VIP-LES/leos-power-pcb/Sp26 Power Board Calculations and Documentation.docx

The power board has two buck converters on it, one to go from the battery voltage (~22.2V to 12V) and another to go from 12V to 5V. This documentation covers the design decisions and calculations for the 22.2V to 12V buck converter.

This buck converter was designed using this buck converter module: TPS55287 36-V, 4-A Buck-Boost Converter with I2C Interface. The data sheet is linked below.

Data Sheet: https://www.ti.com/lit/ds/symlink/tps55287.pdf?ts=1769081225649

The data sheet provides most of what one will need to design a buck converter, but a few key decisions were made. First, we choose to set the output voltage using an external resistor divider. (See pg. 21 in the data sheet for more details about how this changed the normal application circuit.) We did this because the power board is providing power to the other boards and microcontrollers, so a microcontroller on another board cannot be used to set the output voltage, it has to be set by physical components.

Next, we choose the value for RCDC (or also called R2) to be 20 kΩ because we wanted a higher current draw. (See pg. 22 in the data for a graph of output voltage rise versus output current.)

Calculation:

VIN = 3S (11.1 V) or 6S (22.2 V) to VOUT = 12 V

IOUT_LIM = 3A

IOUT = 1A = IL (in buck converters)

- Default limit voltage (between IISP and IISN) is 50 mV
- The CDC helps to compensate for voltage drops across cables/traces, and we choose the resistor value (R2/RCDC)
- For reduce switching power loss in high power conditions (are we using it in high power conditions??), it is recommended to keep the switching frequency below 500 kHz
- Inductor ripple of around 30% ± 10%
- Output current limit = 2.25 A (pdf pg 35)
  - I thought it could go to 4 A??
- Output voltage ripple = ± 50 mV (ΔVOUT)
- Designed to work for inductor values between 1 µH and 10 µH
- Ceramic capacitors are recommended

Calculations:

fSW (in MHz) = 1000/(0.05 ∙ R_(FSW) + 35) = 2.0 MHz

RFSW = 9.3 kΩ

CDITH (also called C8) = 1/(2.8 ∙ R_(FSW) ∙ F_(MOD)) = 47 nF

FMOD = 783.7 Hz

VCDC = 20*(VISP – VISN) = 1V

VOUT_CDC = 3∙R_(FB_UP) ∙(V_(ISP) -V_(ISN))/(R_(CDC)) = 0.75 V

ΔIL(P-P) = 30% * IL = 0.3 A

L = ((V_(IN(MAX)) - V_(OUT) ) ∙ V_(OUT))/(∆I_(L(P-P)) ∙ f_(SW) ∙ V_(IN(MAX))) = 10 µH

ICIN(RMS) = I_(OUT) √((V_(OUT) ∙ (V_(IN) - V_(OUT) ))/(V_(IN) ∙ V_(IN))) = 0.5 A

RSNS = (V_(SNS))/(I_(OUT_LIM)) = 0.0167 Ω = 16.7 mΩ ≈ 16 mΩ

D = (V_(OUT))/(V_(IN(MAX)) ∙ η) = 0.526

RLOAD = (V_(OUT))/(I_(OUT)) = 12 Ω

COUT(MIN) = (ΔI_(L(P-P)))/(8 ∙ f_(SW) ∙ ΔV_(OUT)) = 0.375 µF

COUT = 22 µF

fP = 2/(2π ∙ R_(LOAD) ∙ C_(OUT)) = 1.21 kHz

fESRZ = 1/(2π ∙ R_(LOAD) ∙ C_(OUT)) = 603 Hz

fRHPZ = (R_(LOAD) ∙ (1-D)^2)/(2π ∙ L_1) = 42.9 kHz

RC = (2π ∙ V_(OUT) ∙ R_(SENSE) ∙ C_(OUT) ∙ f_C)/((1-D) ∙ V_(REF) ∙ G_(EA)) = 7.23 kΩ

CC = (R_(LOAD) ∙ C_(OUT))/(2 ∙ R_C) = 18.2 nF

CP = (R_(LOAD) ∙ C_(OUT))/(R_C) = 36.5 nF

VREF = V_(OUT) ∙(R_(FB_BT))/(R_(FB_BT) +R_(FB_UP)) = 1.2 V

RFB_BT = 11.1 kΩ

List of Values to Solve for / Figure out:

- C1 = we get to choose and we will want something very large (recommend at least 0.1 µF)
- C2 = 22 µF (and place four in parallel)
- *C3 > 4.7 µF (there’s no equation for this one)
- C4 = 0.1µF
- C5 = 0.1µF
- C6 (also called CC I think??) = 18.2 nF
- C7 (also called CP I think??) = 36.5 nF
- CDITH (also called C8) = 47 nF
- C9 = This might be nonexistent due to the external resistor divider (pdf pg 21)
- fSW = 2.0 MHz
- RFSW (also called R1) = 9.3 kΩ
- R2 (also called RCDC) = 20 kΩ
- R3 (also called RC) = 370 Ω
- R4 (also called RSNS) = 16 mΩ (need to ensure this resistor has enough power dissipation capability)
- RFB_UP = 100 kΩ
- RFB_BT = 11.1 kΩ
- L1 > 1.2/fSW = 0.6 µH, L1 = 3.33 µH
- FMOD = 783.7 Hz
- VREF = 1.2 V
- VISP – VISN = 50 mV
- VCDC = 1000 mV = 1 V
- VOUT_CDC = 0.75 V
- VIN(MAX) = 24 V
- VSNS = 50 mV
- IL = 1 A
- ΔIL(P-P) = 0.3 A
- ICIN(RMS) (RMS current through the input capacitor) = 0.5 A
- D = 0.526
- η = 95% = 0.95
- RSENSE = 0.055 Ω
- RLOAD = 12 Ω
- COUT = 0.375 µF
- fP = 1.21 kHz
- fESRZ = 603 Hz
- fRHPZ = 42.9 kHz
- fC = 8.57 kHz
- GEA = 190 µA/V
