VIP-LES/leos-power-pcb/Sp26 Jenna's Buck Converter BOM.docx

Format:

Component

- Digikey part #
- Manufacturer
- MPN

All caps: 0805

C_BOOT1, C_BOOT2: 0.1 µF

C_out2, C_out3: 22 µF

C_in2: 47 µF

C_VCC: 4.7 µF

C_SYNC: 47 nF

C_COMP1: 36.5 nF

C_COMP2: 18.2 nF

Inductor: custom footprint

L1: 10 µH

- https://www.digikey.com/en/products/detail/taiyo-yuden/NRS8030T100MJGJ/2665998
- Taiyo Yuden
- NRS8030T100MJGJ

All resistors: 0805

RP1: 10kΩ

- https://www.digikey.com/en/products/detail/bourns-inc/CR0805-FX-1002ELF/3593209
- Bourns Inc.
- CR0805-FX-1002ELF

R_FSW1: 9.3kΩ

- https://www.digikey.com/en/products/detail/bourns-inc/CR0805-FX-9311ELF/3785168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
- Bourns Inc.
- CR0805-FX-9311ELF

RBT1: 11.1kΩ

- https://www.digikey.com/en/products/detail/bourns-inc/CR0805-FX-1102ELF/3784579
- Bourns Inc.
- CR0805-FX-1102ELF

RUP1: 100kΩ

- https://www.digikey.com/en/products/detail/bourns-inc/CR0805-FX-1003ELF/3740947
- Bourns Inc.
- CR0805-FX-1003ELF

R_SNS1: 16mΩ

R_CDC1: 20kΩ

- https://www.digikey.com/en/products/detail/bourns-inc/CR0805-FX-2002ELF/3740952
- Bourns Inc.
- CR0805-FX-2002ELF

R_COMP1: 7.23kΩ

- https://www.digikey.com/en/products/detail/bourns-inc/CR0805-FX-7151ELF/3785097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
- Bourns Inc.
- CR0805-FX-7151ELF

R5: 100kΩ

- https://www.digikey.com/en/products/detail/bourns-inc/CR0805-FX-1003ELF/3740947
- Bourns Inc.
- CR0805-FX-1003ELF

R6: 100kΩ

- https://www.digikey.com/en/products/detail/bourns-inc/CR0805-FX-1003ELF/3740947
- Bourns Inc.
- CR0805-FX-1003ELF

R7: 19.1kΩ

- CR0805-FX-1912ELF Bourns Inc. | Resistors | DigiKey (https://www.digikey.com/en/products/detail/bourns-inc/CR0805-FX-1912ELF/3784722)
- Bourns Inc.
- CR0805-FX-1912ELF
