VIP-LES/leos-power-pcb/LEOS-power.kicad_pcb

## KiCad design LEOS-power.kicad_pcb (2026-04-23)

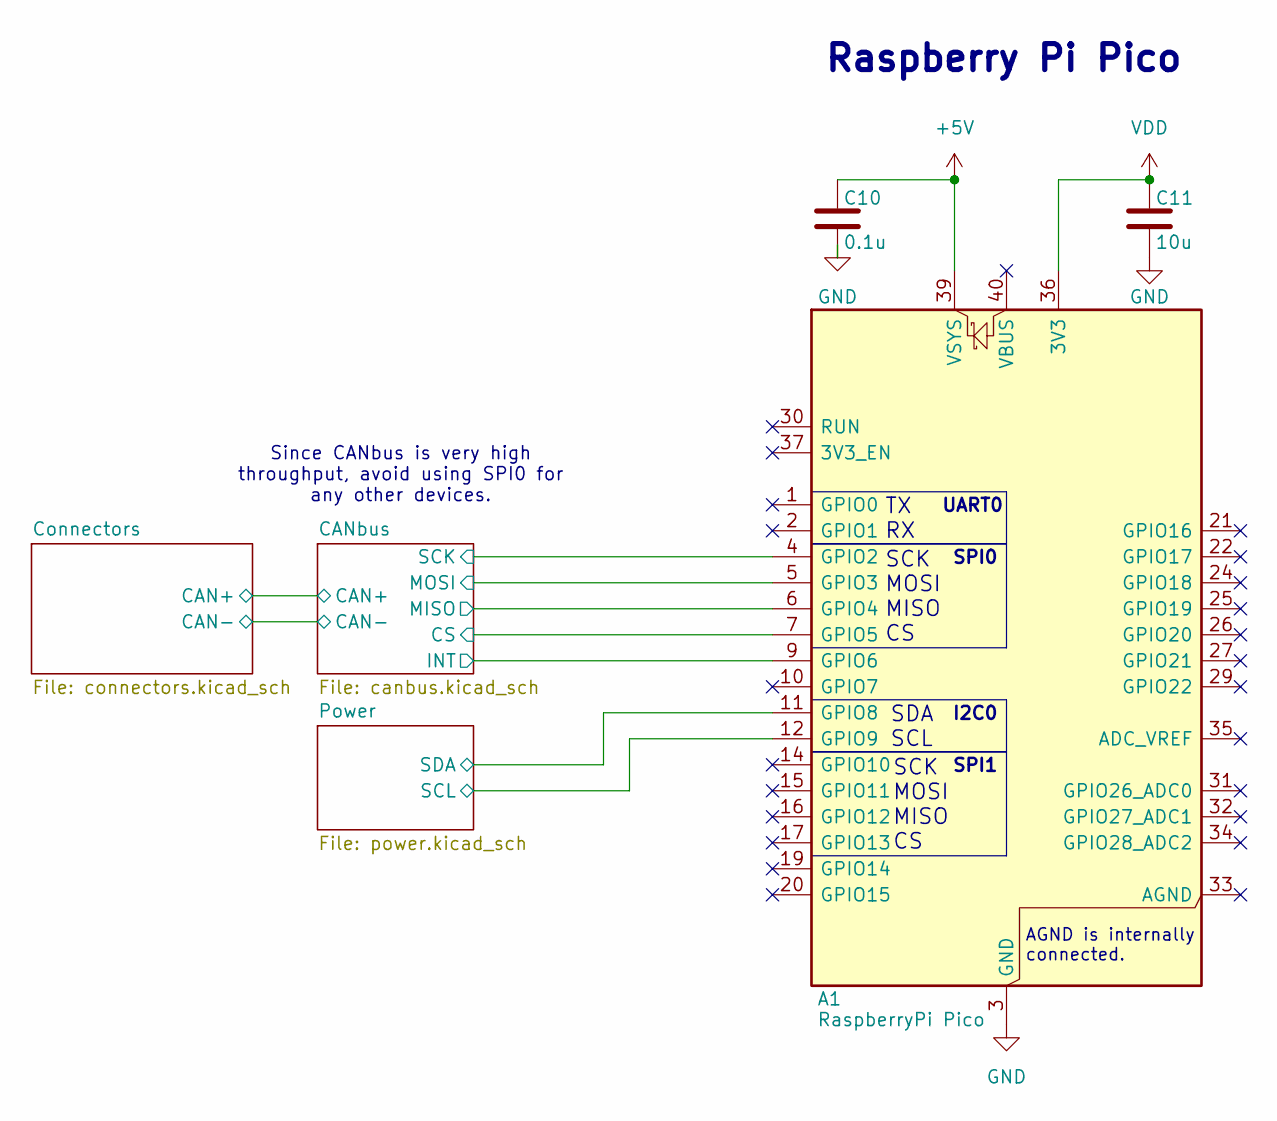
[picture p2: schematic LEOS-power.kicad_sch, LEOS Power]

Parts:
A1: RaspberryPi Pico; RaspberryPi_Pico_Common_THT; MPN PIM724; Digikey 1778-PIM724-ND
C10: 0.1u; C_0603_1608Metric; MPN CL10B104KB8NNNL; Digikey 1276-CL10B104KB8NNNLCT-ND
C11: 10u; C_0805_2012Metric; MPN CL21B106KOQNNNE; Digikey 1276-2872-1-ND

Connections:
+5V: A1.39 (VSYS), C10.1; also elsewhere on the board
/CANbus/CS: A1.7 (GPIO5); also elsewhere on the board
/CANbus/INT: A1.9 (GPIO6); also elsewhere on the board
/CANbus/MISO: A1.6 (GPIO4); also elsewhere on the board
/CANbus/MOSI: A1.5 (GPIO3); also elsewhere on the board
/CANbus/SCK: A1.4 (GPIO2); also elsewhere on the board
/Power/SCL: A1.12 (GPIO9); also elsewhere on the board
/Power/SDA: A1.11 (GPIO8); also elsewhere on the board
GND: A1.3 (GND), A1.8 (GND), A1.13 (GND), A1.18 (GND), A1.23 (GND), A1.28 (GND), A1.38 (GND), C10.2, C11.2; also elsewhere on the board
VDD: A1.36 (3V3), C11.1; also elsewhere on the board

Notes on the sheet:
SPI1
Raspberry Pi Pico
SCK MOSI MISO CS
Since CANbus is very high throughput, avoid using SPI0 for any other devices.
SPI0
SDA SCL
TX RX
UART0
I2C0
AGND is internally connected.

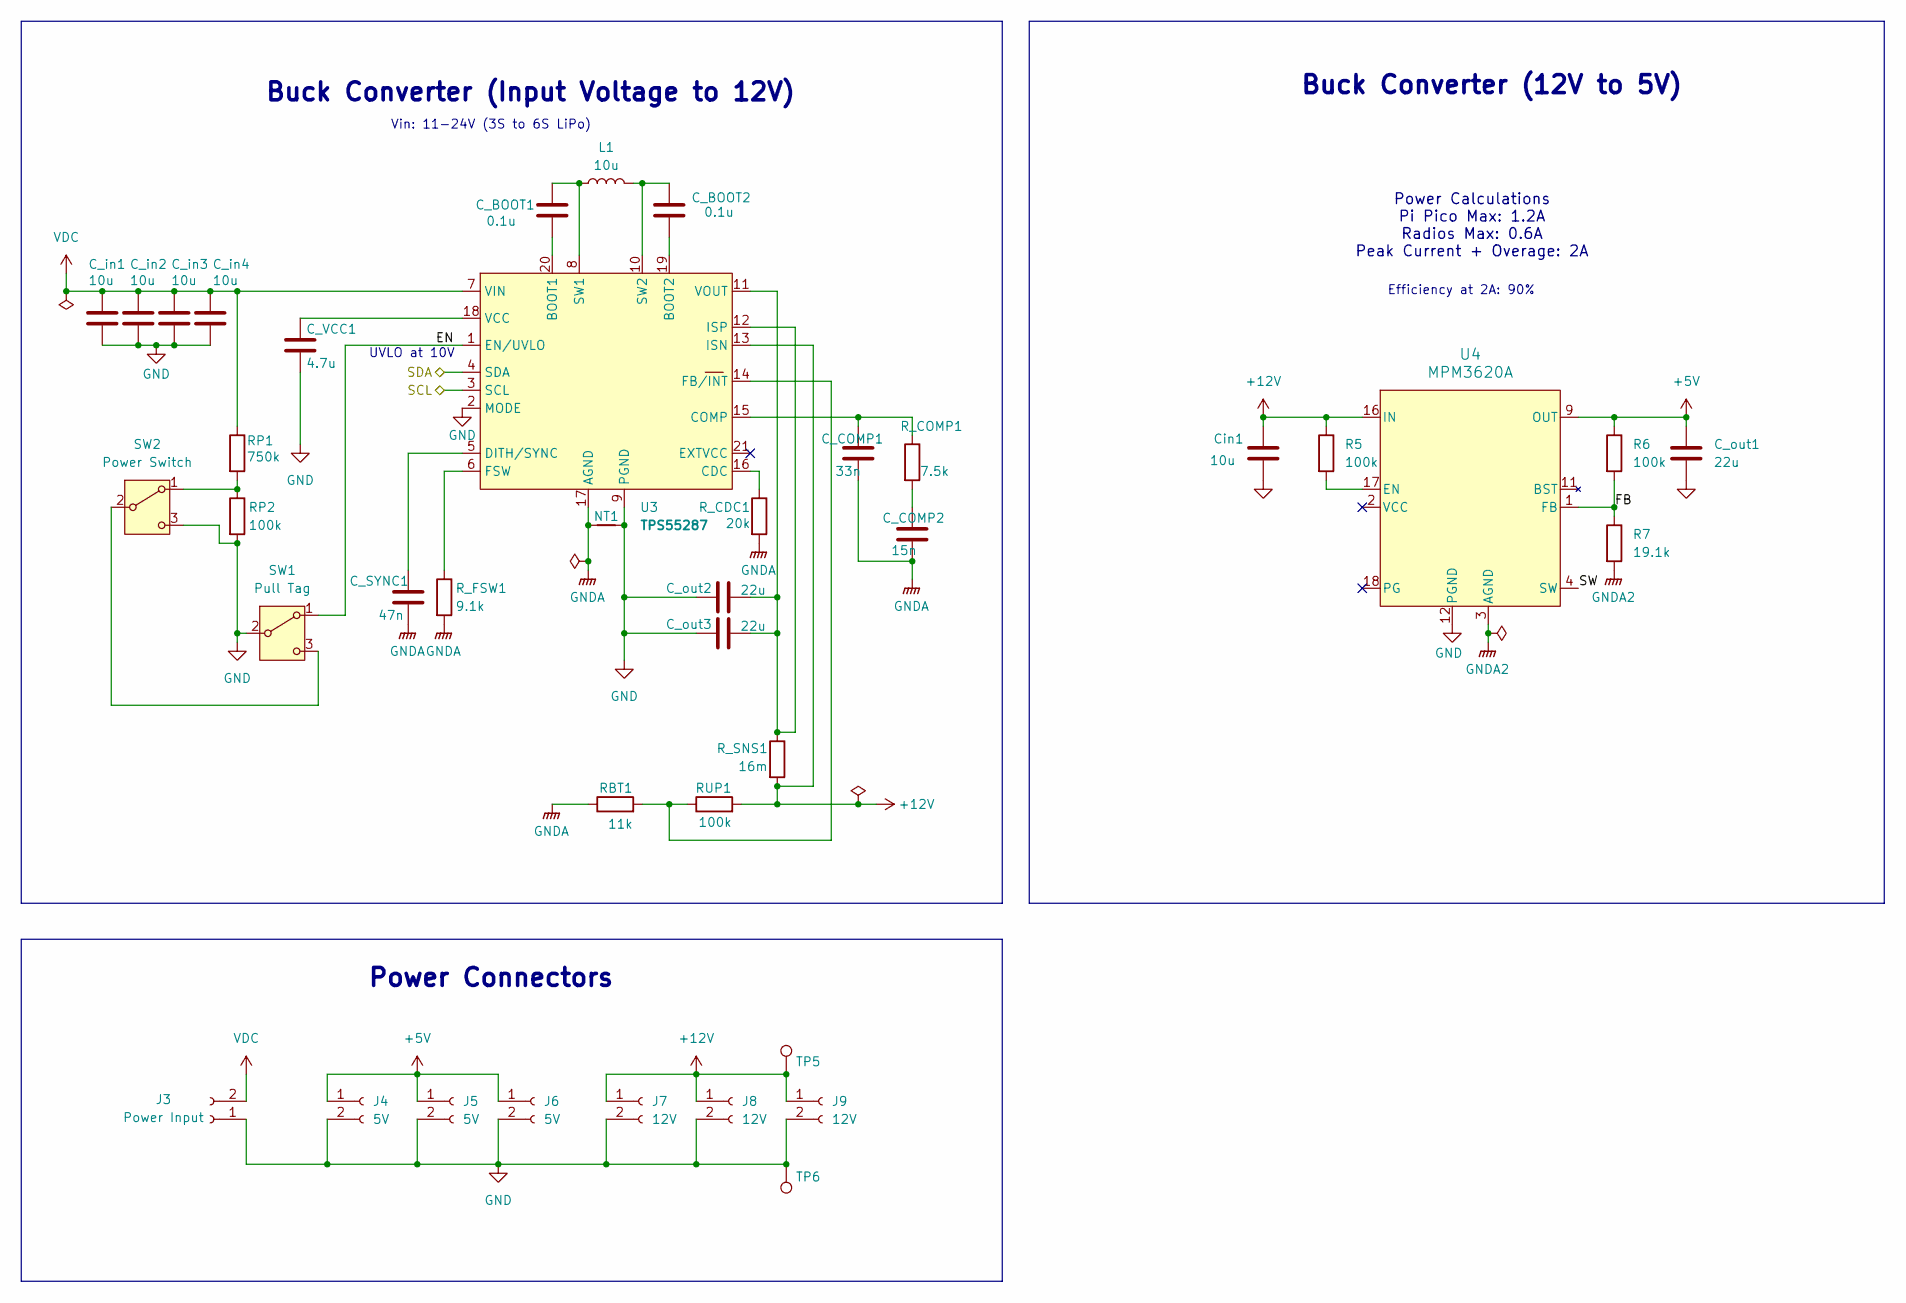
[picture p3: schematic power.kicad_sch, Power & Regulaton]

Parts:
C_BOOT1, C_BOOT2: 0.1u; C_0603_1608Metric; MPN CL10B104KB8NNNL; Digikey 1276-CL10B104KB8NNNLCT-ND
C_COMP1: 33n; C_0603_1608Metric; MPN CL10B333KB8NFNC; Digikey 1276-2040-1-ND
C_COMP2: 15n; C_0603_1608Metric; MPN CL10B153KB8NNNC; Digikey 1276-1277-1-ND
C_SYNC1: 47n; C_0603_1608Metric; MPN CL10B473KB8NNNC; Digikey 1276-1063-1-ND
C_VCC1: 4.7u; C_0805_2012Metric; MPN CL21B475KOFNFNE; Digikey 1276-2970-1-ND
C_in1, C_in2, C_in3, C_in4: 10u; C_1206_3216Metric; MPN CL31B106KBHNNNE; Digikey 1276-6767-1-ND
C_out1, C_out2, C_out3: 22u; C_0805_2012Metric; MPN CL21A226MAYNNNE; Digikey 1276-CL21A226MAYNNNECT-ND
Cin1: 10u; C_0805_2012Metric; MPN CL21B106KOQNNNE; Digikey 1276-2872-1-ND
J3: Power Input; AMASS_XT60IPW-M_1x03_P7.20mm_Horizontal
J4, J5, J6: 5V; JST_XH_S2B-XH-A_1x02_P2.50mm_Horizontal; MPN S2B-XH-A; Digikey 455-S2B-XH-A-ND
J7, J8, J9: 12V; JST_XH_S2B-XH-A_1x02_P2.50mm_Horizontal; MPN S2B-XH-A; Digikey 455-S2B-XH-A-ND
L1: 10u; IND_TAIYO_NRS8030_TAY; MPN NRS8030T100MJGJ; Digikey 587-2960-1-ND
NT1: NetTie_2; NetTie-2_SMD_Pad0.5mm
R5, R6: 100k; R_0805_2012Metric_Pad1.20x1.40mm_HandSolder; MPN CRCW0805100KFKEA; Digikey 541-100KCCT-ND
R7: 19.1k; R_0805_2012Metric_Pad1.20x1.40mm_HandSolder; MPN CRCW080519K1FKEA; Digikey 541-19.1KCCT-ND
RBT1: 11k; R_0805_2012Metric_Pad1.20x1.40mm_HandSolder; MPN CRCW080511K0FKEAC; Digikey 541-CRCW080511K0FKEACCT-ND
RP1: 750k; R_0805_2012Metric; MPN CRCW0805750KFKEA; Digikey 541-750KCCT-ND
RP2: 100k; R_0805_2012Metric; MPN CRCW0805100KFKEA; Digikey 541-100KCCT-ND
RUP1: 100k; R_0805_2012Metric_Pad1.20x1.40mm_HandSolder; MPN CRCW0805100KFKEA; Digikey 541-100KCCT-ND
R_CDC1: 20k; R_0805_2012Metric_Pad1.20x1.40mm_HandSolder; MPN CRCW080520K0FKEA; Digikey 541-20.0KCCT-ND
R_COMP1: 7.5k; R_0805_2012Metric_Pad1.20x1.40mm_HandSolder; MPN CRCW08057K50FKEAC; Digikey 541-CRCW08057K50FKEACCT-ND
R_FSW1: 9.1k; R_0805_2012Metric_Pad1.20x1.40mm_HandSolder; MPN CRCW08059K10FKEA; Digikey 541-9.10KCCT-ND
R_SNS1: 16m; R_0805_2012Metric_Pad1.20x1.40mm_HandSolder; MPN WSLP0805R0160FEA; Digikey 541-WSLP0805R0160FEACT-ND
SW1: Pull Tag; D2F-FL-A1; MPN D2F-FL-A1; Digikey SW1146-ND
SW2: Power Switch; SW_Slide_SPDT_Angled_CK_OS102011MA1Q; MPN EG1206A; Digikey EG1917-ND
TP5: 12V Test; TestPoint_Loop_D2.60mm_Drill0.9mm_Beaded; MPN 5000; Digikey 36-5000-ND
TP6: GND Test Point; TestPoint_Loop_D2.60mm_Drill0.9mm_Beaded; MPN 5001; Digikey 36-5001-ND
U3: TPS55287; VQFN21_RYQ_TEX; MPN TPS55287QWRYQRQ1; Digikey 296-TPS55287QWRYQRQ1CT-ND
U4: MPM3620A; IC18_MPM3620AGQV-Z_MNP; MPN MPM3620AGQV-Z; Digikey 1589-1764-1-ND

Connections:
+5V: C_out1.1, J4.1, J5.1, J6.1, R6.1, U4.7 (OUT), U4.8 (OUT), U4.9 (OUT), U4.22 (OUT); also elsewhere on the board
+12V: Cin1.1, J7.1, J8.1, J9.1, R5.1, RUP1.2, R_SNS1.2, TP5.1, U3.13 (ISN), U4.16 (IN)
/Power/EN: SW1.1 (A), U3.1 (EN/UVLO)
/Power/FB: R6.2, R7.1, U4.1 (FB)
/Power/SCL: U3.3 (SCL); also elsewhere on the board
/Power/SDA: U3.4 (SDA); also elsewhere on the board
/Power/SW: U4.4 (SW), U4.5 (SW), U4.6 (SW), U4.21 (SW)
GND: C_VCC1.2, C_in1.2, C_in2.2, C_in3.2, C_in4.2, C_out1.2, C_out2.1, C_out3.1, Cin1.2, J3.1, J4.2, J5.2, J6.2, J7.2, J8.2, J9.2, NT1.2, RP2.2, SW1.2 (B), SW2.3 (C), TP6.1, U3.2 (MODE), U3.9 (PGND), U4.12 (PGND), U4.13 (PGND), U4.14 (PGND); also elsewhere on the board
GNDA: C_COMP1.2, C_COMP2.2, C_SYNC1.2, NT1.1, RBT1.1, R_CDC1.2, R_FSW1.2, U3.17 (AGND)
GNDA2: R7.2, U4.3 (AGND)
unnamed: C_COMP2.1, R_COMP1.2
unnamed: SW1.3 (C), SW2.2 (B)
unnamed: RP1.2, RP2.1, SW2.1 (A)
unnamed: C_BOOT1.2, U3.20 (BOOT1)
unnamed: C_BOOT2.2, U3.19 (BOOT2)
unnamed: R_CDC1.1, U3.16 (CDC)
unnamed: C_COMP1.1, R_COMP1.1, U3.15 (COMP)
unnamed: C_SYNC1.1, U3.5 (DITH/SYNC)
unnamed: RBT1.2, RUP1.1, U3.14 (FB/INT)
unnamed: R_FSW1.1, U3.6 (FSW)
unnamed: C_out2.2, C_out3.2, R_SNS1.1, U3.11 (VOUT), U3.12 (ISP)
unnamed: C_BOOT1.1, L1.1, U3.8 (SW1)
unnamed: C_BOOT2.1, L1.2, U3.10 (SW2)
unnamed: C_VCC1.1, U3.18 (VCC)
unnamed: R5.2, U4.17 (EN)
VDC: C_in1.1, C_in2.1, C_in3.1, C_in4.1, J3.2, RP1.1, U3.7 (VIN)

Notes on the sheet:
Efficiency at 2A: 90%
Buck Converter (Input Voltage to 12V)
UVLO at 10V
Power Connectors
Buck Converter (12V to 5V)
Power Calculations Pi Pico Max: 1.2A Radios Max: 0.6A Peak Current + Overage: 2A
Vin: 11-24V (3S to 6S LiPo)

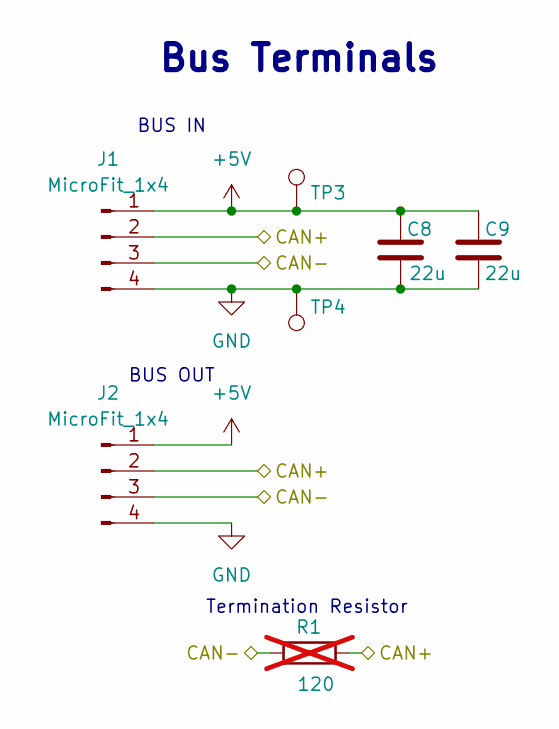
[picture p4: schematic connectors.kicad_sch, LEOS Connectors]

Parts:
C8, C9: 22u; C_0805_2012Metric; MPN CL21A226MAYNNNE; Digikey 1276-CL21A226MAYNNNECT-ND
J1, J2: MicroFit_1x4; Molex_MicroFit3.0_43650-0410_1x04_Horizontal; MPN 0436500409; Digikey WM1882CT-ND
R1: 120; R_Axial_DIN0207_L6.3mm_D2.5mm_P7.62mm_Horizontal; MPN CF14JT120R; Digikey CF14JT120RCT-ND; not fitted
TP3: 5V Test Point; TestPoint_Loop_D2.60mm_Drill0.9mm_Beaded; MPN 5000; Digikey 36-5000-ND
TP4: GND Test Point; TestPoint_Loop_D2.60mm_Drill0.9mm_Beaded; MPN 5001; Digikey 36-5001-ND

Connections:
+5V: C8.1, C9.1, J1.1, J2.1, TP3.1; also elsewhere on the board
/CANbus/CAN+: J1.2, J2.2, R1.2; also elsewhere on the board
/CANbus/CAN-: J1.3, J2.3, R1.1; also elsewhere on the board
GND: C8.2, C9.2, J1.4, J2.4, TP4.1; also elsewhere on the board

Notes on the sheet:
BUS OUT
Bus Terminals
BUS IN
Termination Resistor

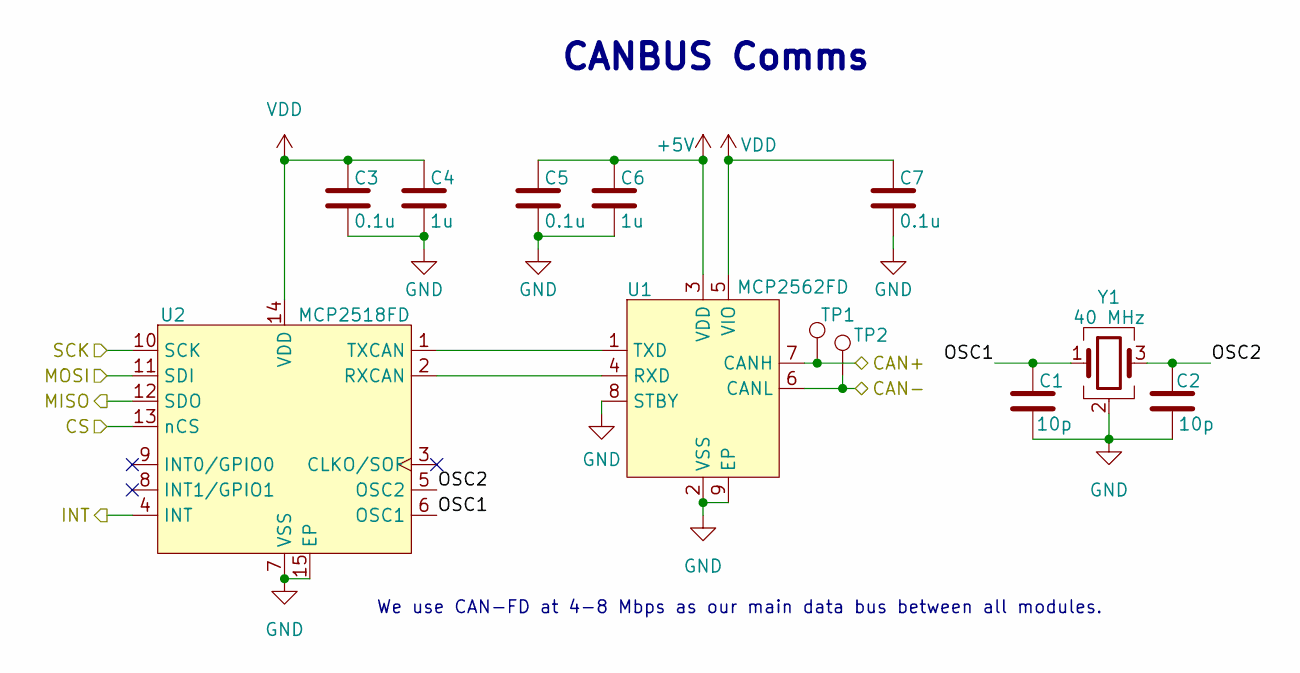
[picture p5: schematic canbus.kicad_sch, LEOS CANbus]

Parts:
C1, C2: 10p; C_0603_1608Metric; MPN CL10C100JB8NNNC; Digikey 1276-1027-1-ND
C3, C5, C7: 0.1u; C_0603_1608Metric; MPN CL10B104KB8NNNL; Digikey 1276-CL10B104KB8NNNLCT-ND
C4, C6: 1u; C_0603_1608Metric; MPN CL10B105KA8NNNC; Digikey 1276-1184-1-ND
TP1: CAN-H Test Point; TestPoint_Loop_D2.60mm_Drill0.9mm_Beaded; MPN 5004; Digikey 36-5004-ND
TP2: CAN-L Test Point; TestPoint_Loop_D2.60mm_Drill0.9mm_Beaded; MPN 5116; Digikey 36-5116-ND
U1: MCP2562FD; SOIC-8_3.9x4.9mm_P1.27mm; MPN MCP2562FDT-E/SN; LCSC C511335
U2: MCP2518FD; SOIC-14_3.9x8.7mm_P1.27mm; MPN MCP2518FDT-E/SL; LCSC C626758
Y1: 40 MHz; Crystal_SMD_2016-4Pin_2.0x1.6mm; MPN ECS-400-10-37B2-CKY-TR; Digikey 50-ECS-400-10-37B2-CKY-TRCT-ND

Connections:
+5V: C5.1, C6.1, U1.3 (VDD); also elsewhere on the board
/CANbus/CAN+: TP1.1, U1.7 (CANH); also elsewhere on the board
/CANbus/CAN-: TP2.1, U1.6 (CANL); also elsewhere on the board
/CANbus/CS: U2.13 (nCS); also elsewhere on the board
/CANbus/INT: U2.4 (INT); also elsewhere on the board
/CANbus/MISO: U2.12 (SDO); also elsewhere on the board
/CANbus/MOSI: U2.11 (SDI); also elsewhere on the board
/CANbus/OSC1: C1.2, U2.6 (OSC1), Y1.1
/CANbus/OSC2: C2.2, U2.5 (OSC2), Y1.3
/CANbus/SCK: U2.10 (SCK); also elsewhere on the board
GND: C1.1, C2.1, C3.2, C4.2, C5.2, C6.2, C7.2, U1.2 (VSS), U1.8 (STBY), U1.9 (EP), U2.7 (VSS), U2.15 (EP), Y1.2 (G), Y1.4 (G); also elsewhere on the board
unnamed: U1.4 (RXD), U2.2 (RXCAN)
unnamed: U1.1 (TXD), U2.1 (TXCAN)
VDD: C3.1, C4.1, C7.1, U1.5 (VIO), U2.14 (VDD); also elsewhere on the board

Notes on the sheet:
CANBUS Comms
We use CAN-FD at 4-8 Mbps as our main data bus between all modules.

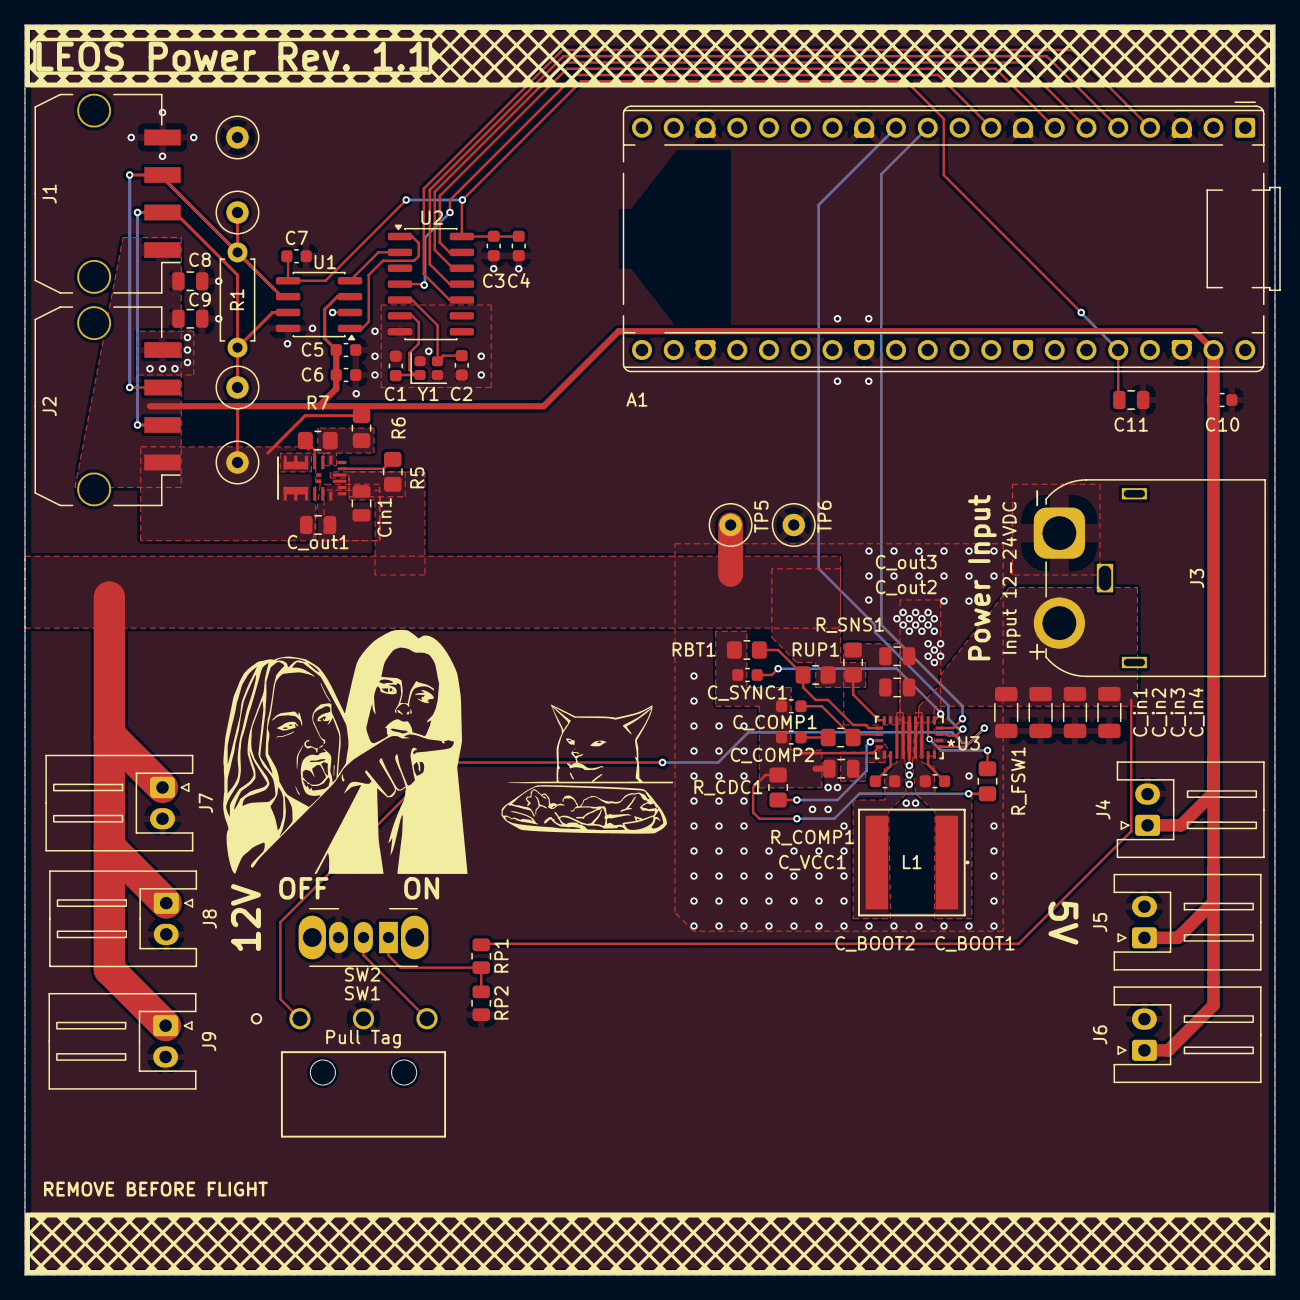
[picture p6: board LEOS-power.kicad_pcb from above]

Board: 2 copper layers, 100.0 x 100.0 mm, 62 parts (0 on the bottom side), 38 nets.
