VIP-LES/leos-power-pcb/(commit log)

2026-02-06 Added buck converter and components, plus their values
    [LEOS-stack-template.kicad_sch]
2026-02-06 Added the 12-5V buck converter to the schematic
    [LEOS-stack-template.kicad_pcb, LEOS-stack-template.kicad_sch]
2026-02-06 added a 12-5V buck converter to the schematic
2026-02-11 updates to schematic and added footprints
    [LEOS-stack-template.kicad_pcb]
2026-02-13 routed the 12-5V buck converter
    [LEOS-stack-template.kicad_pcb]
2026-02-14 mostly routed the vin to 12V buck converter
    [LEOS-stack-template.kicad_pcb, LEOS-stack-template.kicad_sch]
2026-02-18 added some more ground nodes
    [LEOS-stack-template.kicad_pcb]
2026-02-18 added more ground nodes
2026-02-18 connected the Vin to 12V buck converter to ground!!!!!!
    [LEOS-stack-template.kicad_pcb]
2026-02-20 Update to new template
    [LEOS-power.kicad_pcb, LEOS-power.kicad_sch, LEOS-stack-template.kicad_pcb, LEOS-stack-template.kicad_sch, canbus.kicad_sch, connectors.kicad_sch, power.kicad_sch]
2026-02-20 Power board complete v1.0
    [LEOS-power.kicad_pcb, power.kicad_sch]
2026-02-20 v1.1 Fix UVLO and EN power source
    [LEOS-power.kicad_pcb, LEOS-power.kicad_sch, power.kicad_sch]
2026-04-23 Add files via upload
    battery to 12V buck converter documentation
